DavidTheFighter/co2_sensor/co2_sensor_module/co2_sensor_module.kicad_pcb

## KiCad design co2_sensor_module/co2_sensor_module.kicad_pcb (2026-10-12)

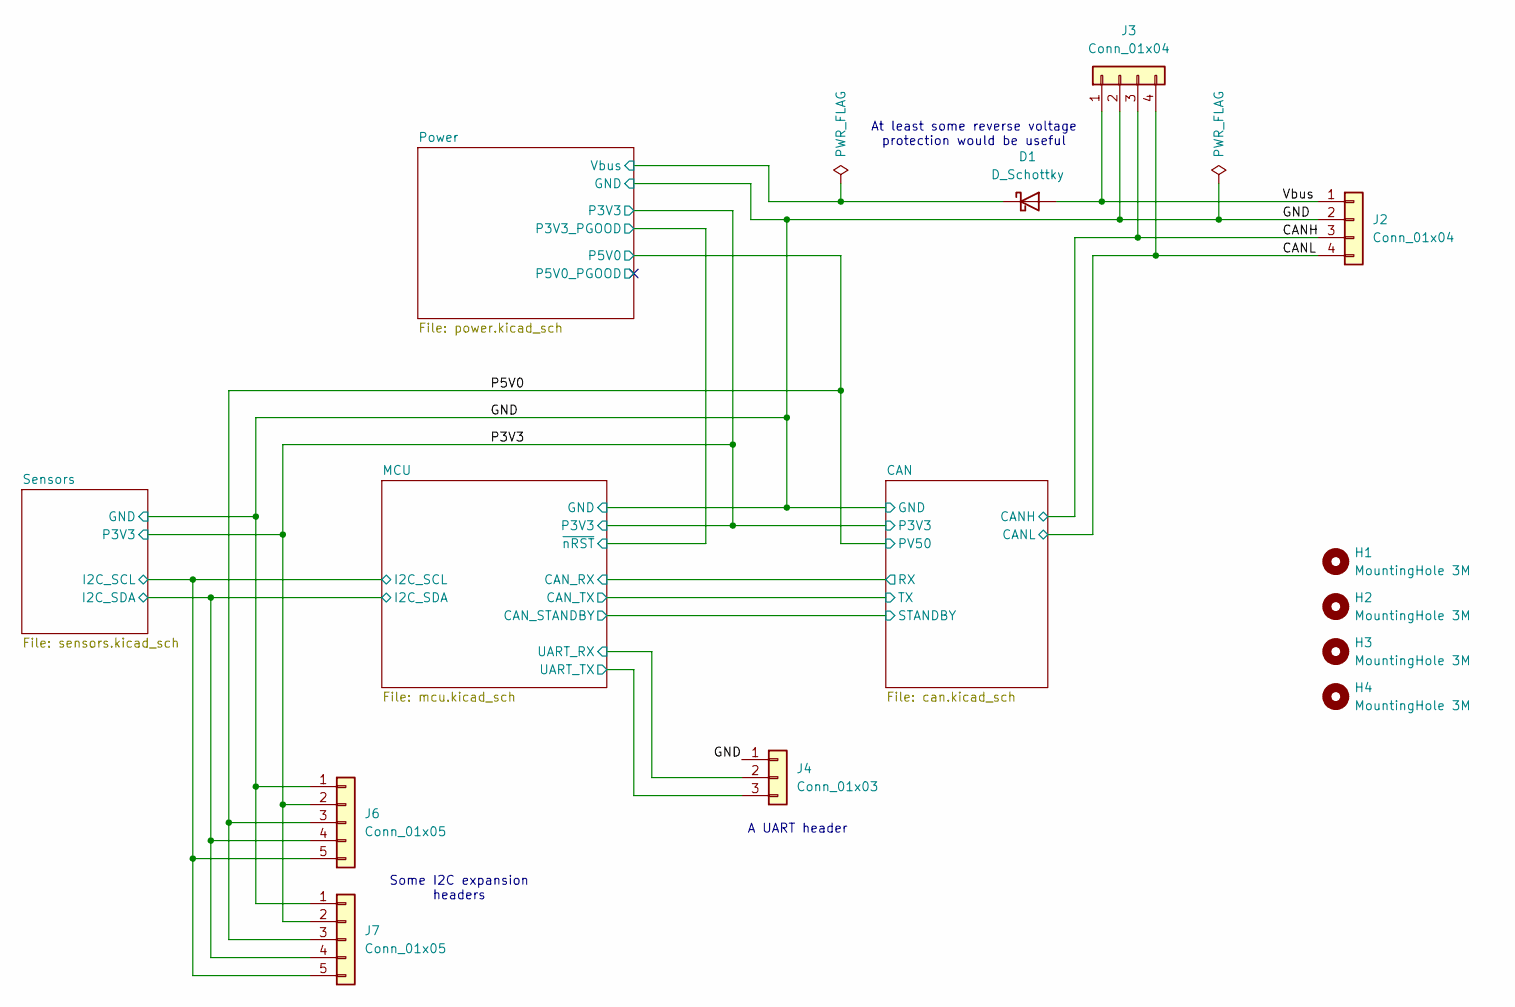
[picture p1: schematic co2_sensor_module.kicad_sch]

Parts:
D1: D_Schottky; D_SOD-123; LCSC C8598
H1, H2, H3, H4: MountingHole 3M; MountingHole_3.2mm_M3
J2, J3: Conn_01x04; JST_PH_B4B-PH-K_1x04_P2.00mm_Vertical
J4: Conn_01x03; PinHeader_1x03_P2.54mm_Vertical
J6, J7: Conn_01x05; PinHeader_1x05_P2.54mm_Vertical

Connections:
/CANH: J2.3, J3.3; also elsewhere on the board
/CANL: J2.4, J3.4; also elsewhere on the board
/GND: J2.2, J3.2, J4.1, J6.1, J7.1; also elsewhere on the board
/MCU/I2C_SCL: J6.5, J7.5; also elsewhere on the board
/MCU/I2C_SDA: J6.4, J7.4; also elsewhere on the board
/MCU/UART_RX: J4.2; also elsewhere on the board
/MCU/UART_TX: J4.3; also elsewhere on the board
/P3V3: J6.2, J7.2; also elsewhere on the board
/P5V0: J6.3, J7.3; also elsewhere on the board
/Power/Vbus: D1.1 (K); also elsewhere on the board
/Vbus: D1.2 (A), J2.1, J3.1

Notes on the sheet:
Some I2C expansion headers
At least some reverse voltage protection would be useful
A UART header

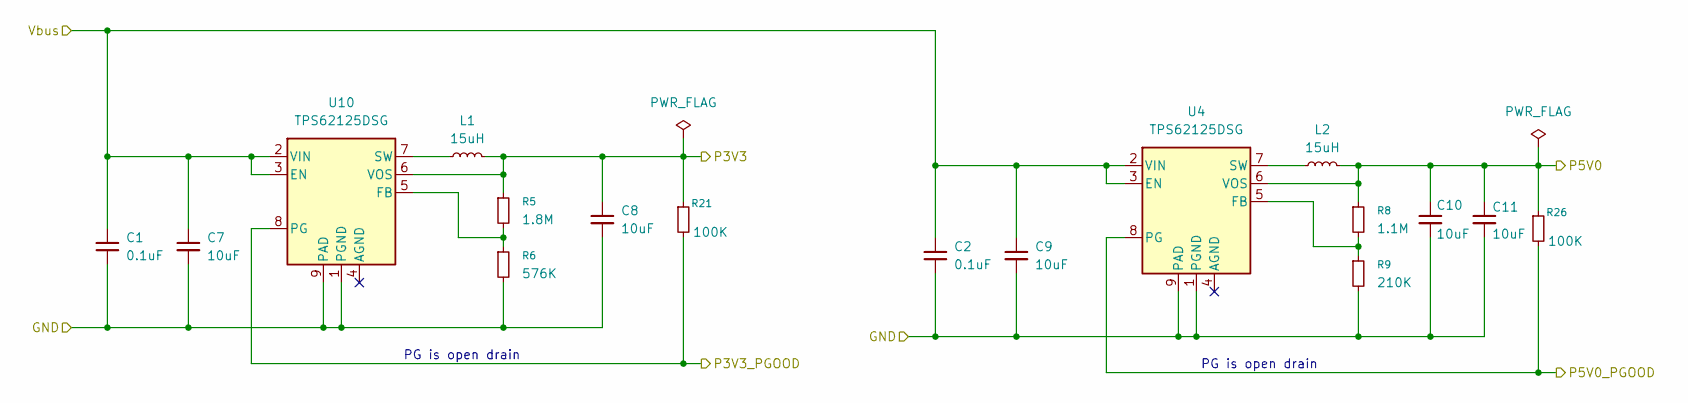
[picture p2: schematic power.kicad_sch]

Parts:
C1, C2: 0.1uF; C_0603_1608Metric; LCSC C14663
C7, C8, C9, C10, C11: 10uF; C_0805_2012Metric; LCSC C15850
L1, L2: 15uH; L_1008_2520Metric; LCSC C5832376
R5: 1.8M; R_0402_1005Metric; LCSC C2933079
R6: 576K; R_0402_1005Metric; LCSC C2085028
R8: 1.1M; R_0402_1005Metric; LCSC C2930013
R9: 210K; R_0402_1005Metric; LCSC C2998176
R21, R26: 100K; C_0402_1005Metric; LCSC C25741
U4, U10: TPS62125DSG; Texas_DSG0008A_WSON-8-1EP_2x2mm_P0.5mm_EP0.9x1.6mm; LCSC C324076

Connections:
/GND: C1.2, C2.2, C7.2, C8.2, C9.2, C10.2, C11.2, R6.2, R9.2, U4.1 (PGND), U4.9 (PAD), U10.1 (PGND), U10.9 (PAD); also elsewhere on the board
/MCU/~nRST: R21.2, U10.8 (PG); also elsewhere on the board
/P3V3: C8.1, L1.2, R5.1, R21.1, U10.6 (VOS); also elsewhere on the board
/P5V0: C10.1, C11.1, L2.2, R8.1, R26.1, U4.6 (VOS); also elsewhere on the board
/Power/P5V0_PGOOD: R26.2, U4.8 (PG)
/Power/Vbus: C1.1, C2.1, C7.1, C9.1, U4.2 (VIN), U4.3 (EN), U10.2 (VIN), U10.3 (EN); also elsewhere on the board
unnamed: R8.2, R9.1, U4.5 (FB)
unnamed: L2.1, U4.7 (SW)
unnamed: R5.2, R6.1, U10.5 (FB)
unnamed: L1.1, U10.7 (SW)

Notes on the sheet:
PG is open drain

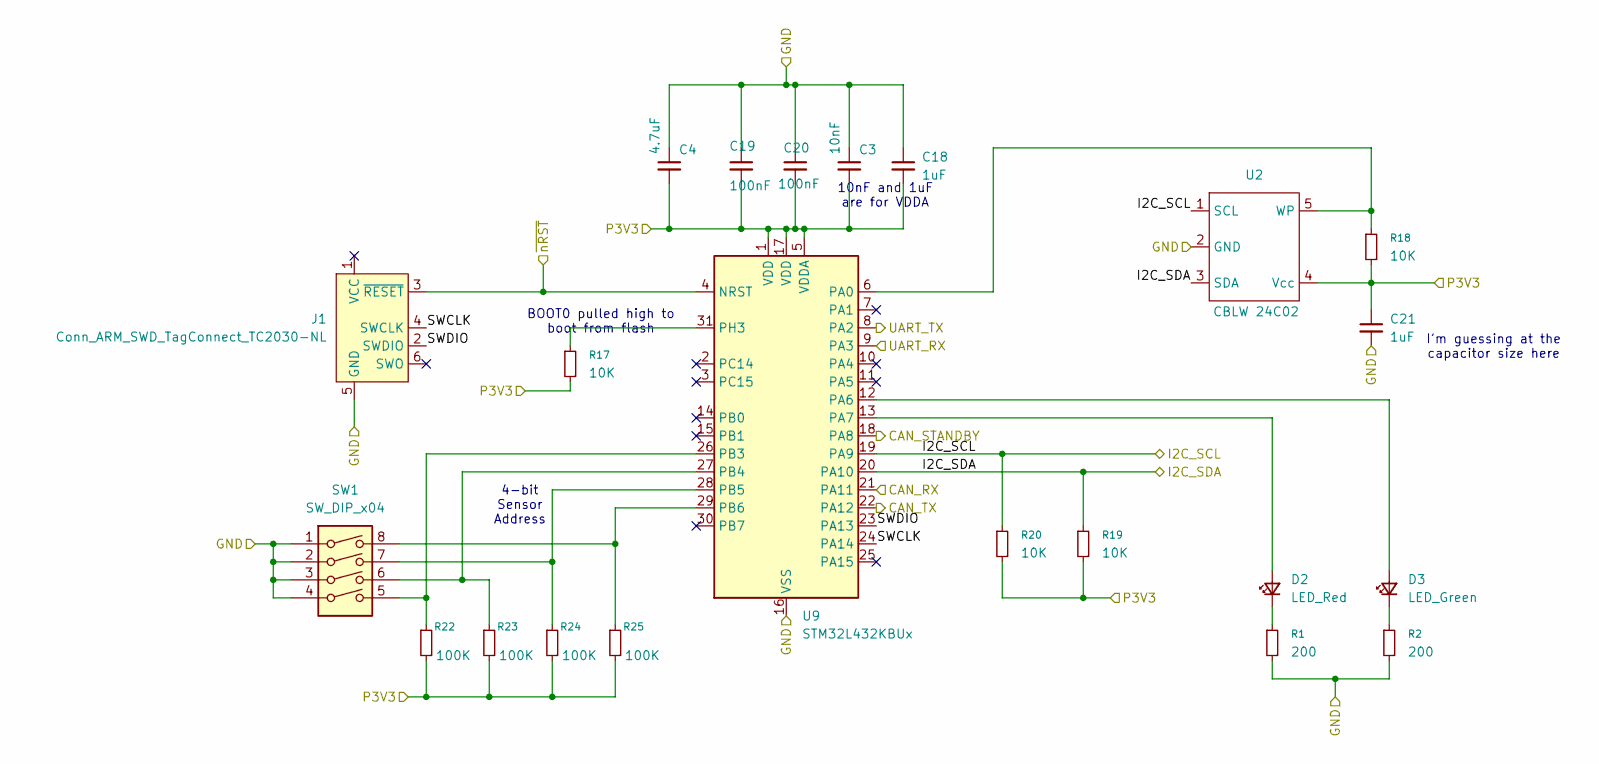
[picture p3: schematic mcu.kicad_sch]

Parts:
C3: 10nF; C_0402_1005Metric; LCSC C15195
C4: 4.7uF; C_0603_1608Metric; LCSC C19666
C18, C21: 1uF; C_0603_1608Metric; LCSC C15849
C19, C20: 100nF; C_0402_1005Metric; LCSC C1525
D2: LED_Red; LED_0805_2012Metric; LCSC C84256
D3: LED_Green; LED_0805_2012Metric; LCSC C2297
J1: Conn_ARM_SWD_TagConnect_TC2030-NL; Tag-Connect_TC2030-IDC-NL_2x03_P1.27mm_Vertical
R1, R2: 200; R_0603_1608Metric; LCSC C8218
R17, R18, R19, R20: 10K; R_0402_1005Metric; LCSC C25744
R22, R23, R24, R25: 100K; C_0402_1005Metric; LCSC C25741
SW1: SW_DIP_x04; SW_DIP_SPSTx04_Slide_9.78x12.34mm_W7.62mm_P2.54mm
U2: CBLW 24C02; SOT-23-5; LCSC C18723540
U9: STM32L432KBUx; QFN-32-1EP_5x5mm_P0.5mm_EP3.45x3.45mm; LCSC C2928224

Connections:
/CAN/RX: U9.21 (PA11); also elsewhere on the board
/CAN/STANDBY: U9.18 (PA8); also elsewhere on the board
/CAN/TX: U9.22 (PA12); also elsewhere on the board
/GND: C3.1, C4.1, C18.1, C19.1, C20.1, C21.2, J1.5 (GND), R1.2, R2.2, SW1.1, SW1.2, SW1.3, SW1.4, U2.2 (GND), U9.16 (VSS), U9.32 (VSS), U9.33 (VSS); also elsewhere on the board
/MCU/I2C_SCL: R20.1, U2.1 (SCL), U9.19 (PA9); also elsewhere on the board
/MCU/I2C_SDA: R19.1, U2.3 (SDA), U9.20 (PA10); also elsewhere on the board
/MCU/SWCLK: J1.4 (SWCLK), U9.24 (PA14)
/MCU/SWDIO: J1.2 (SWDIO), U9.23 (PA13)
/MCU/UART_RX: U9.9 (PA3); also elsewhere on the board
/MCU/UART_TX: U9.8 (PA2); also elsewhere on the board
/MCU/~nRST: J1.3 (~RESET), U9.4 (NRST); also elsewhere on the board
/P3V3: C3.2, C4.2, C18.2, C19.2, C20.2, C21.1, R17.2, R18.2, R19.2, R20.2, R22.2, R23.2, R24.2, R25.2, U2.4 (Vcc), U9.1 (VDD), U9.5 (VDDA), U9.17 (VDD); also elsewhere on the board
unnamed: D2.2 (A), U9.13 (PA7)
unnamed: D2.1 (K), R1.1
unnamed: D3.2 (A), U9.12 (PA6)
unnamed: D3.1 (K), R2.1
unnamed: R18.1, U2.5 (WP), U9.6 (PA0)
unnamed: R22.1, SW1.5, U9.26 (PB3)
unnamed: R23.1, SW1.6, U9.27 (PB4)
unnamed: R24.1, SW1.7, U9.28 (PB5)
unnamed: R25.1, SW1.8, U9.29 (PB6)
unnamed: R17.1, U9.31 (PH3)

Notes on the sheet:
BOOT0 pulled high to boot from flash
I'm guessing at the capacitor size here
10nF and 1uF are for VDDA
4-bit Sensor Address

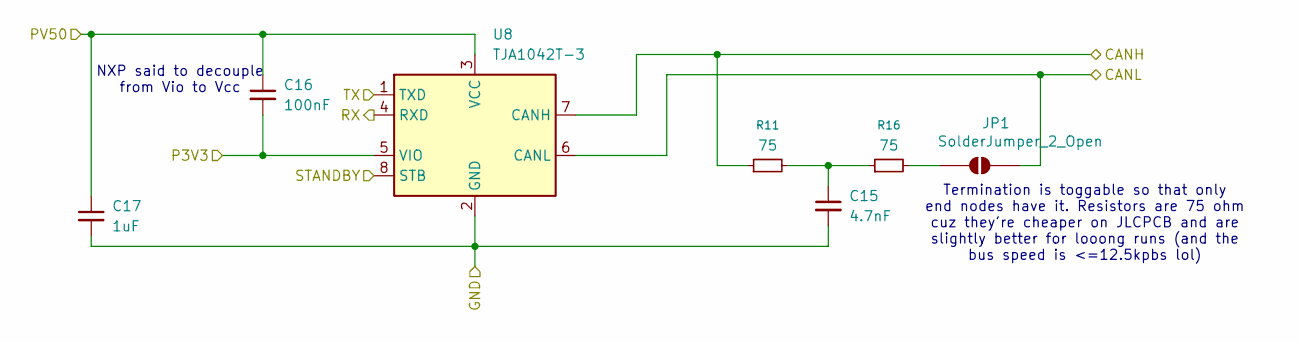
[picture p4: schematic can.kicad_sch]

Parts:
C15: 4.7nF; C_0805_2012Metric; LCSC C1744
C16: 100nF; C_0402_1005Metric; LCSC C1525
C17: 1uF; C_0603_1608Metric; LCSC C15849
JP1: SolderJumper_2_Open; SolderJumper-2_P1.3mm_Open_TrianglePad1.0x1.5mm
R11, R16: 75; R_0603_1608Metric; LCSC C4275
U8: TJA1042T-3; SOIC-8_3.9x4.9mm_P1.27mm; LCSC C132227

Connections:
/CAN/RX: U8.4 (RXD); also elsewhere on the board
/CAN/STANDBY: U8.8 (STB); also elsewhere on the board
/CAN/TX: U8.1 (TXD); also elsewhere on the board
/CANH: R11.1, U8.7 (CANH); also elsewhere on the board
/CANL: JP1.2 (B), U8.6 (CANL); also elsewhere on the board
/GND: C15.2, C17.2, U8.2 (GND); also elsewhere on the board
/P3V3: C16.2, U8.5 (VIO); also elsewhere on the board
/P5V0: C16.1, C17.1, U8.3 (VCC); also elsewhere on the board
unnamed: C15.1, R11.2, R16.1
unnamed: JP1.1 (A), R16.2

Notes on the sheet:
Termination is toggable so that only end nodes have it. Resistors are 75 ohm cuz they're cheaper on JLCPCB and are slightly better for looong runs (and the bus speed is <=12.5kpbs lol)
NXP said to decouple from Vio to Vcc

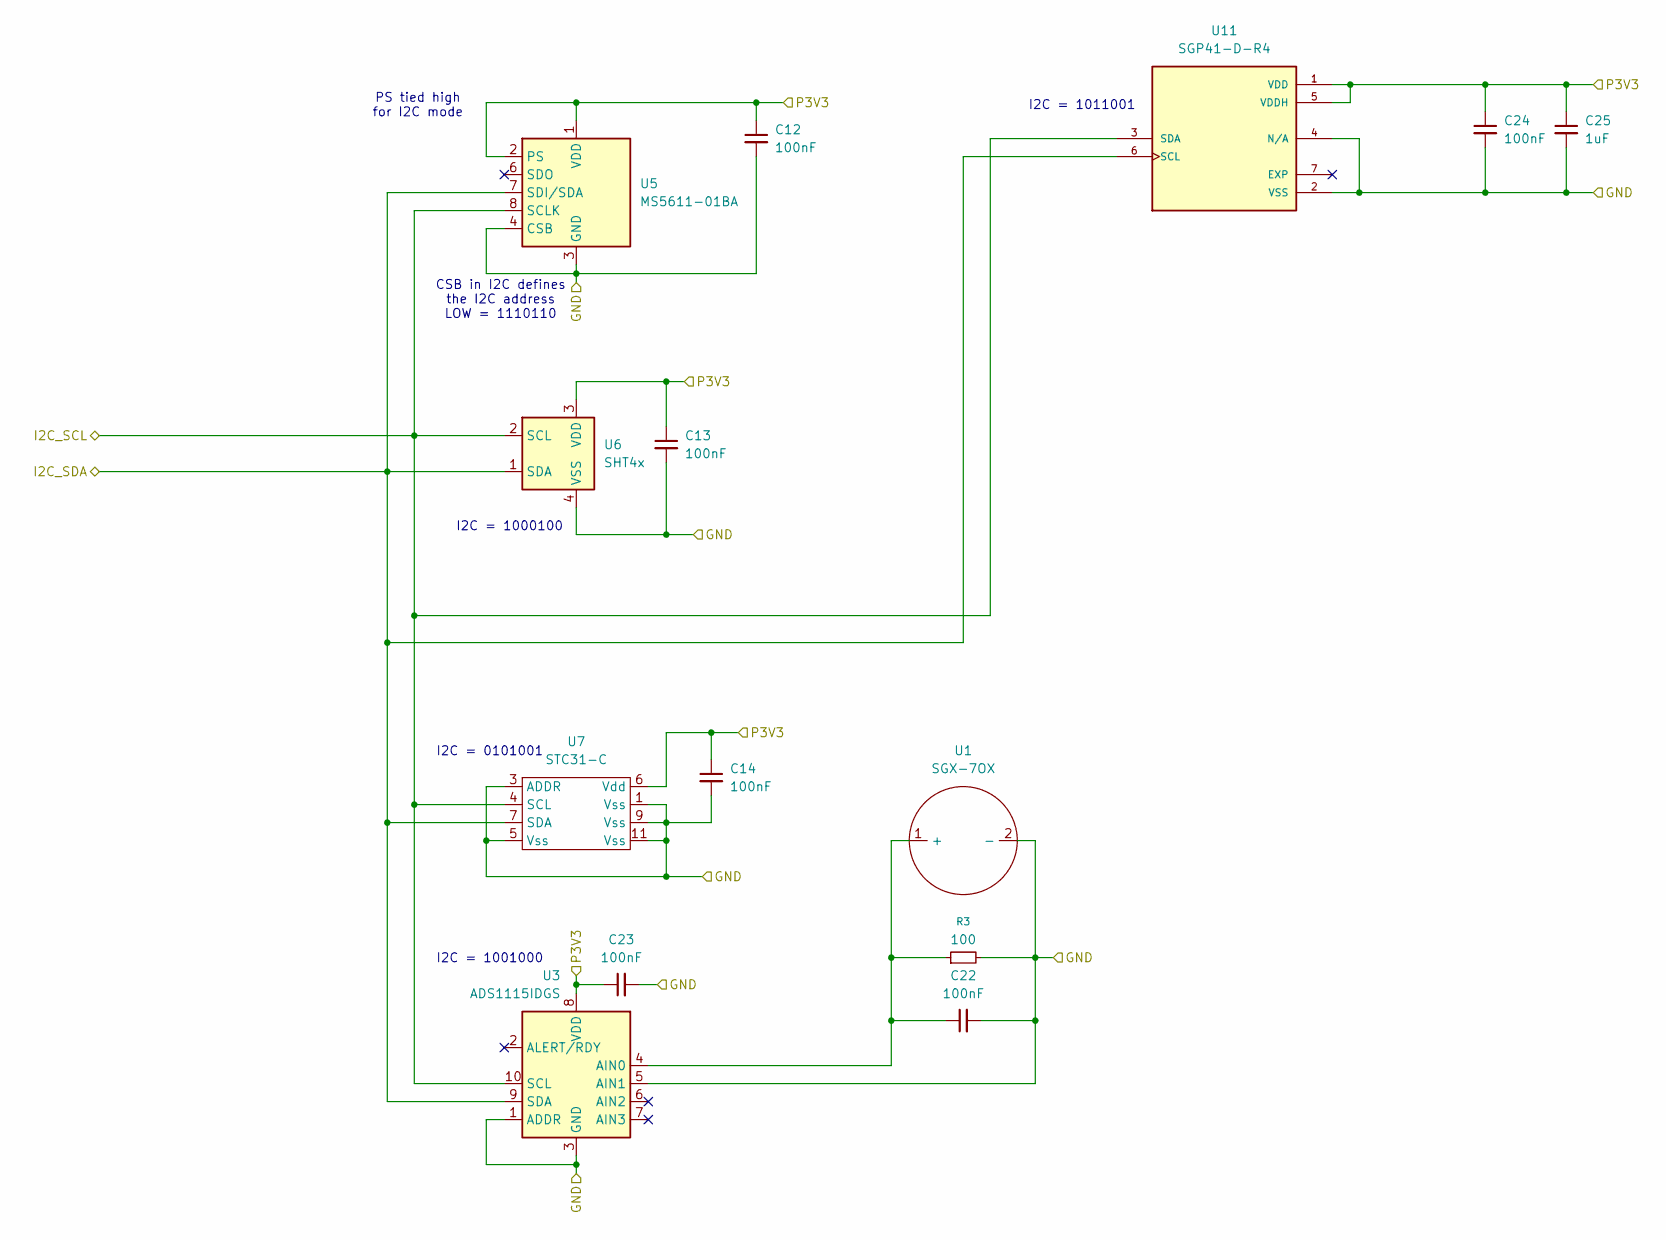
[picture p5: schematic sensors.kicad_sch]

Parts:
C12, C13, C14, C22, C23, C24: 100nF; C_0402_1005Metric; LCSC C1525
C25: 1uF; C_0603_1608Metric; LCSC C15849
R3: 100; R_0603_1608Metric; LCSC C122970
U1: SGX-7OX
U3: ADS1115IDGS; TSSOP-10_3x3mm_P0.5mm; LCSC C37593
U5: MS5611-01BA; LGA-8_3x5mm_P1.25mm; LCSC C15639
U6: SHT4x; Sensirion_DFN-4_1.5x1.5mm_P0.8mm_SHT4x_NoCentralPad; LCSC C2909890
U7: STC31-C; STC31-C-R5; LCSC C22396918
U11: SGP41-D-R4; XDCR_SGP41-D-R4; LCSC C3659325

Connections:
/GND: C12.2, C13.2, C14.2, C22.2, C23.2, C24.2, C25.2, R3.2, U1.2 (-), U3.1 (ADDR), U3.3 (GND), U3.5 (AIN1), U5.3 (GND), U5.4 (CSB), U5.5 (CSB), U6.4 (VSS), U7.1 (Vss), U7.3 (ADDR), U7.5 (Vss), U7.9 (Vss), U7.11 (Vss), U11.2 (VSS), U11.4 (N/A); also elsewhere on the board
/MCU/I2C_SCL: U3.10 (SCL), U5.8 (SCLK), U6.2 (SCL), U7.4 (SCL), U11.3 (SDA); also elsewhere on the board
/MCU/I2C_SDA: U3.9 (SDA), U5.7 (SDI/SDA), U6.1 (SDA), U7.7 (SDA), U11.6 (SCL); also elsewhere on the board
/P3V3: C12.1, C13.1, C14.1, C23.1, C24.1, C25.1, U3.8 (VDD), U5.1 (VDD), U5.2 (PS), U6.3 (VDD), U7.6 (Vdd), U11.1 (VDD), U11.5 (VDDH); also elsewhere on the board
unnamed: C22.1, R3.1, U1.1 (+), U3.4 (AIN0)

Notes on the sheet:
I2C = 1001000
I2C = 0101001
PS tied high for I2C mode
I2C = 1011001
CSB in I2C defines the I2C address LOW = 1110110
I2C = 1000100

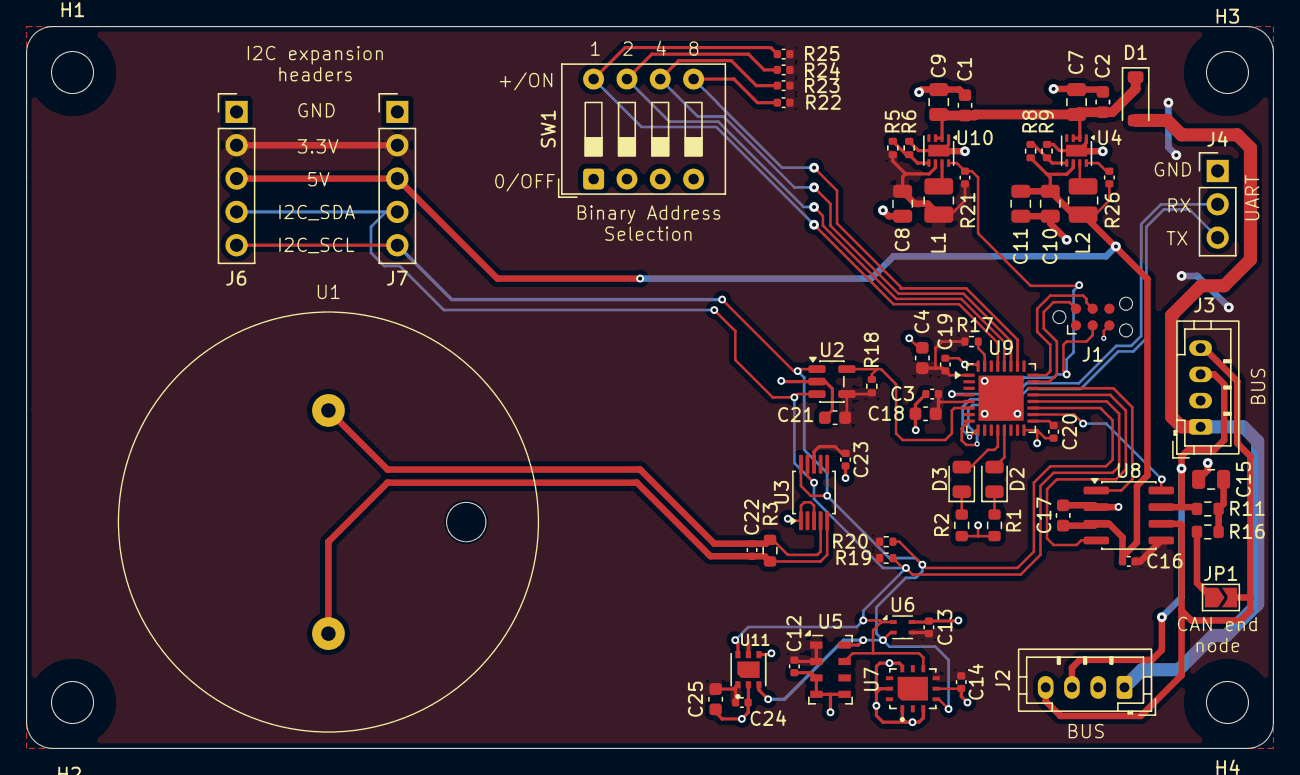
[picture p6: board co2_sensor_module.kicad_pcb from above]

Board: 2 copper layers, 95.0 x 55.0 mm, 70 parts (0 on the bottom side), 35 nets.
