DavidTheFighter/co2_sensor/co2_hub/co2_hub.ioc

Mcu.UserName=STM32L433RCTx
PA10.Signal=I2C1_SDA
PA11.Signal=USB_DM
PA12.Signal=USB_DP
PA6.Signal=LPUART1_CTS
PA9.Signal=I2C1_SCL
PB1.Signal=LPUART1_RTS
PB6.Signal=USART1_TX
PB7.Signal=USART1_RX
PB8.Signal=CAN1_RX
PB9.Signal=CAN1_TX
PC0.Signal=LPUART1_RX
PC1.Signal=LPUART1_TX
