DavidTheFighter/co2_sensor/(commit log)

2026-07-23 first pass
    [co2_sensor_module.kicad_pcb, co2_sensor_module.kicad_sch, mcu.kicad_sch, power.kicad_sch]
2026-07-27 mostly done w/ sensor module
    [can.kicad_sch, co2_sensor_module.kicad_sch, mcu.kicad_sch, power.kicad_sch, sensors.kicad_sch]
2026-07-30 first draft of sensor schematic is done!
    [can.kicad_sch, co2_sensor_module.kicad_sch, mcu.kicad_sch, power.kicad_sch]
2026-09-30 added wip hub + o2 sensor
    [bms.kicad_sch, cell.kicad_sch, co2_hub.kicad_pcb, co2_hub.kicad_sch, co2_sensor_module.kicad_pcb, co2_sensor_module.kicad_sch, mcu.kicad_sch, power.kicad_sch]
2026-09-30 some work on layout for co2 sensor unit
    [co2_sensor_module.kicad_pcb, co2_sensor_module.kicad_sch]
2026-10-01 more routing
    [co2_sensor_module.kicad_pcb, sensors.kicad_sch]
2026-10-03 mostly done with sensor module
    [bom.csv, cell.kicad_sch, co2_sensor_module.csv, co2_sensor_module.kicad_pcb, designators.csv, mcu.kicad_sch, positions.csv, power.kicad_sch]
2026-10-21 progress on solar charging + misc
2026-10-22 added custom symbols + footprints
